WheeledCord/thinkpad-keyboard-usb/README.md

A PCB to allow a thinkpad laptop keyboard to be used as a USB keyboard.
