WheeledCord/thinkpad-keyboard-usb/kicad/T61.kicad_pcb

## KiCad design kicad/T61.kicad_pcb (2025-07-11)

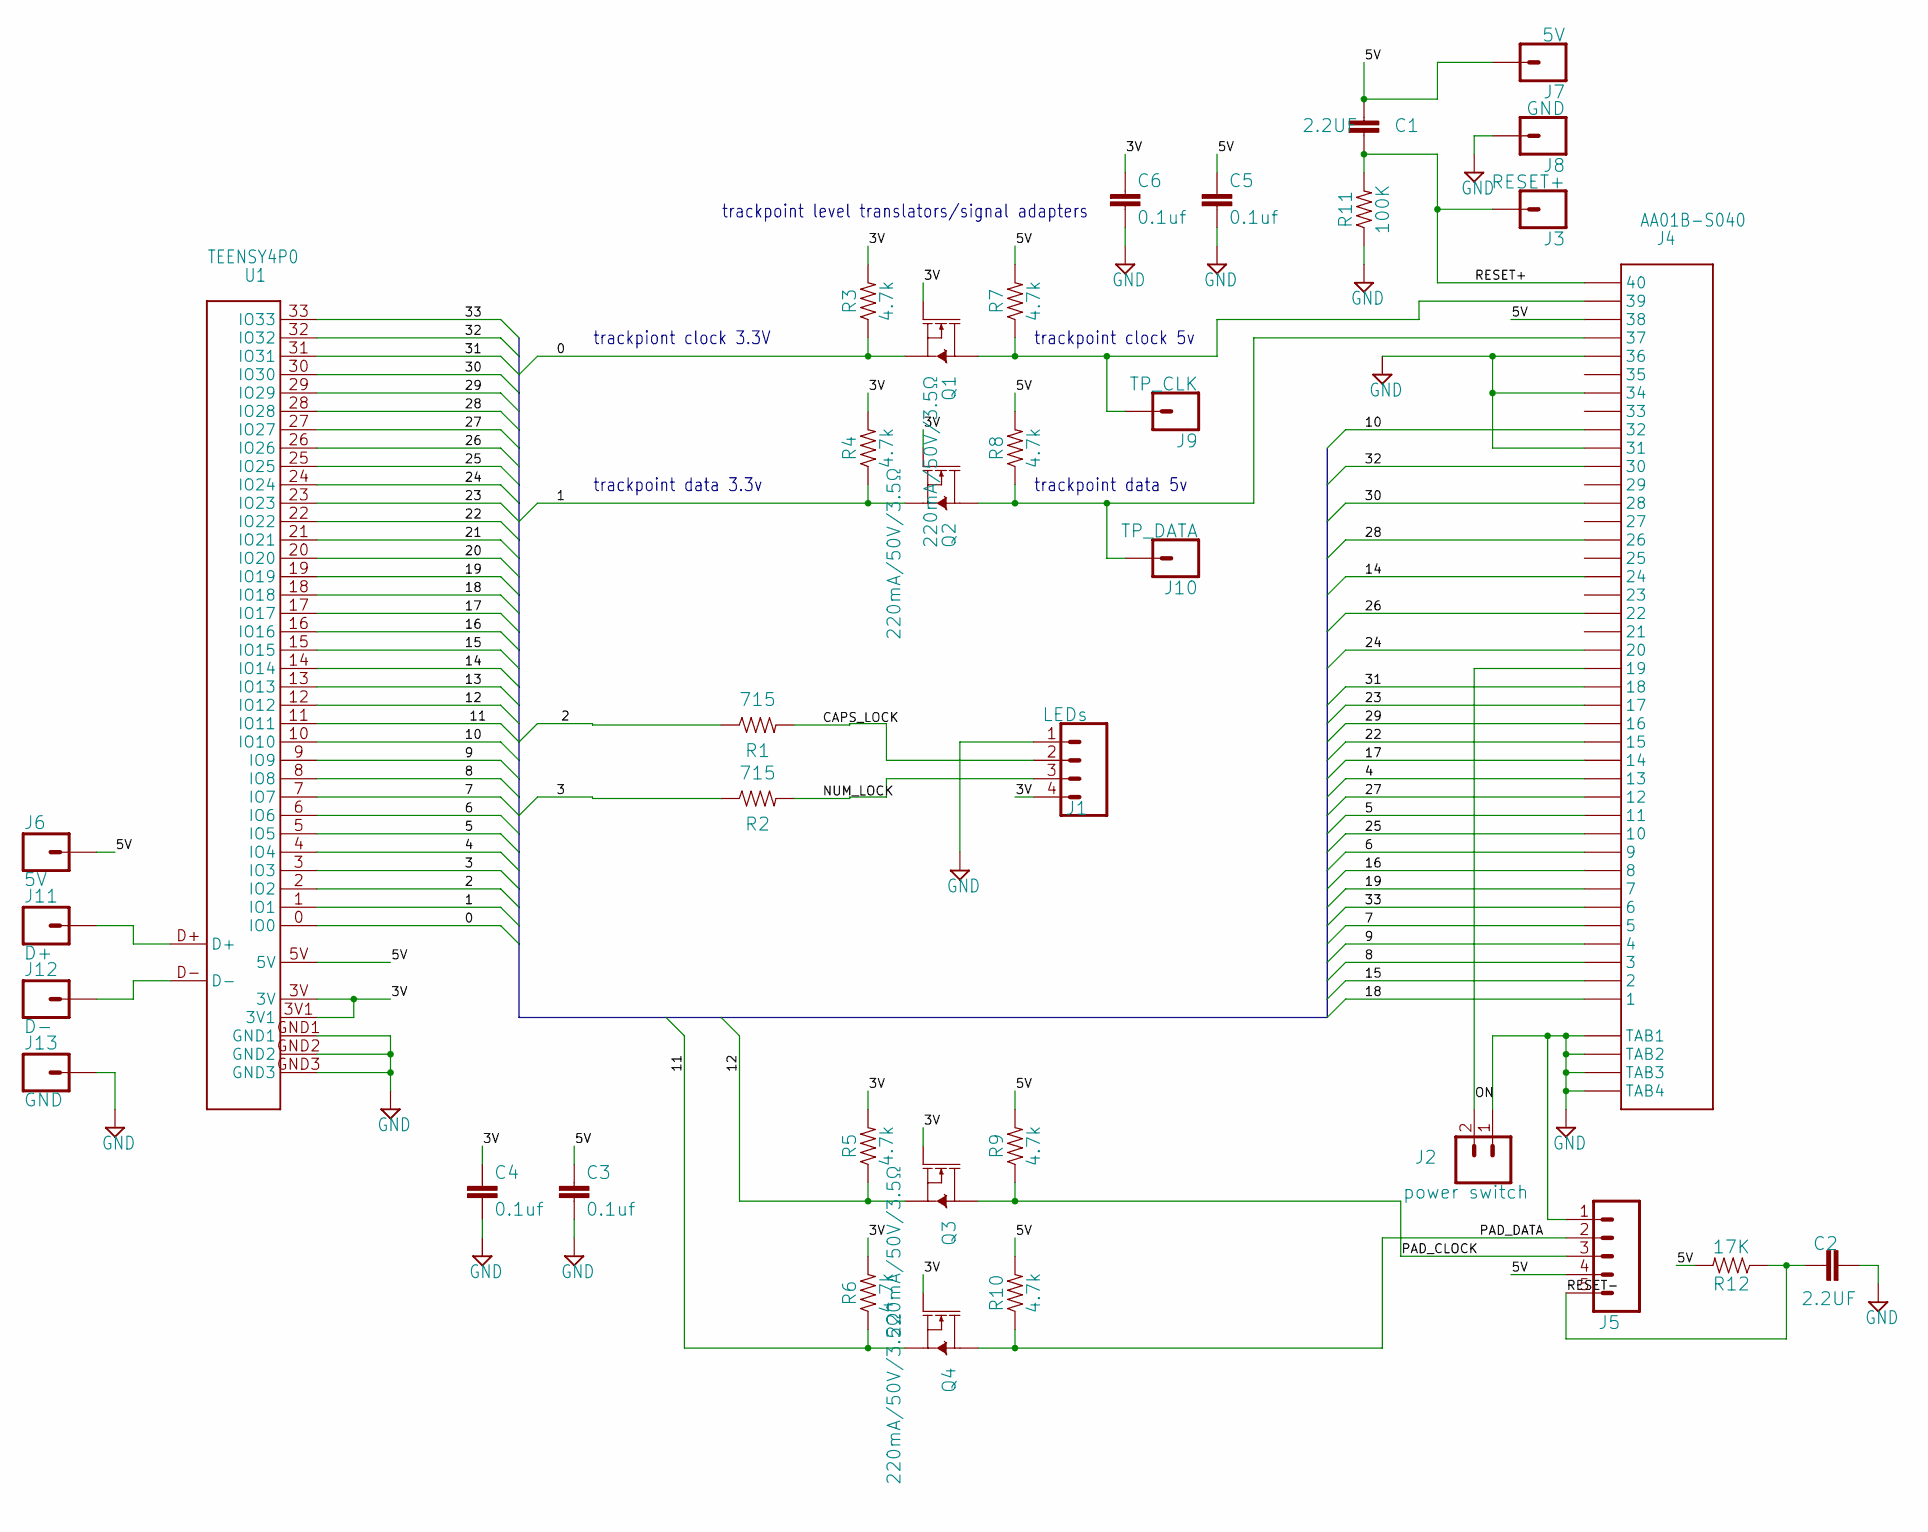
[picture p1: schematic T61.kicad_sch]

Parts:
C1, C2: 2.2UF; 0603_CAP
C3, C4, C5, C6: 0.1uf; 0603_CAP
J1: LEDs; 1X04
J2: power switch; 1X02
J3: RESET+; 1X01_NO_SILK
J4: AA01B-S040; WM6787_AA01B
J5: Touchpad_Signals; 1X05
J6, J7: 5V; 1X01_NO_SILK
J8, J13: GND; 1X01_NO_SILK
J9: TP_CLK; 1X01_NO_SILK
J10: TP_DATA; 1X01_NO_SILK
J11: D+; 1X01_NO_SILK
J12: D-; 1X01_NO_SILK
Q1, Q2, Q3, Q4: 220mA/50V/3.5Ω; SOT23-3
R1, R2: 715; 0603
R3, R4, R5, R6, R7, R8, R9, R10: 4.7k; 0603
R11: 100K; 0603_RESISTOR
R12: 17K; 0603_RESISTOR
U1: TEENSY4P0

Connections:
0: Q1.2 (S), R3.1, U1.0 (IO0)
1: Q2.2 (S), R4.1, U1.1 (IO1)
2: R1.1, U1.2 (IO2)
3: R2.1, U1.3 (IO3)
3V: C4.1, C6.1, J1.4, Q1.1 (G), Q2.1 (G), Q3.1 (G), Q4.1 (G), R3.2, R4.2, R5.2, R6.2, U1.3V, U1.3V1
4: J4.P$13 (13), U1.4 (IO4)
5: J4.P$11 (11), U1.5 (IO5)
5V: C1.1, C3.1, C5.1, J4.P$38 (38), J5.4, J6.1, J7.1, R7.2, R8.2, R9.2, R10.2, R12.2, U1.5V
6: J4.P$9 (9), U1.6 (IO6)
7: J4.P$5 (5), U1.7 (IO7)
8: J4.P$3 (3), U1.8 (IO8)
9: J4.P$4 (4), U1.9 (IO9)
10: J4.P$32 (32), U1.10 (IO10)
11: Q4.2 (S), R6.1, U1.11 (IO11)
12: Q3.2 (S), R5.1, U1.12 (IO12)
13: U1.13 (IO13)
14: J4.P$24 (24), U1.14 (IO14)
15: J4.P$2 (2), U1.15 (IO15)
16: J4.P$8 (8), U1.16 (IO16)
17: J4.P$14 (14), U1.17 (IO17)
18: J4.P$1 (1), U1.18 (IO18)
19: J4.P$7 (7), U1.19 (IO19)
20: U1.20 (IO20)
21: U1.21 (IO21)
22: J4.P$15 (15), U1.22 (IO22)
23: J4.P$17 (17), U1.23 (IO23)
24: J4.P$20 (20), U1.24 (IO24)
25: J4.P$10 (10), U1.25 (IO25)
26: J4.P$22 (22), U1.26 (IO26)
27: J4.P$12 (12), U1.27 (IO27)
28: J4.P$26 (26), U1.28 (IO28)
29: J4.P$16 (16), U1.29 (IO29)
30: J4.P$28 (28), U1.30 (IO30)
31: J4.P$18 (18), U1.31 (IO31)
32: J4.P$30 (30), U1.32 (IO32)
33: J4.P$6 (6), U1.33 (IO33)
CAPS_LOCK: J1.2, R1.2
D+: J11.1, U1.D+
D-: J12.1, U1.D-
GND: C2.2, C3.2, C4.2, C5.2, C6.2, J1.1, J2.1, J4.P$31 (31), J4.P$34 (34), J4.P$36 (36), J4.TAB1, J4.TAB2, J4.TAB3, J4.TAB4, J5.1, J8.1, J13.1, R11.1, U1.GND1, U1.GND2, U1.GND3
NUM_LOCK: J1.3, R2.2
ON: J2.2, J4.P$19 (19)
PAD_CLOCK: J5.3, Q3.3 (D), R9.1
PAD_DATA: J5.2, Q4.3 (D), R10.1
RESET+: C1.2, J3.1, J4.P$40 (40), R11.2
RESET-: C2.1, J5.5, R12.1
TP_CLK: J4.P$39 (39), J9.1, Q1.3 (D), R7.1
TP_DATA: J4.P$37 (37), J10.1, Q2.3 (D), R8.1

Notes on the sheet:
trackpoint data 5v
trackpiont clock 3.3V
trackpoint level translators/signal adapters
trackpoint clock 5v
trackpoint data 3.3v

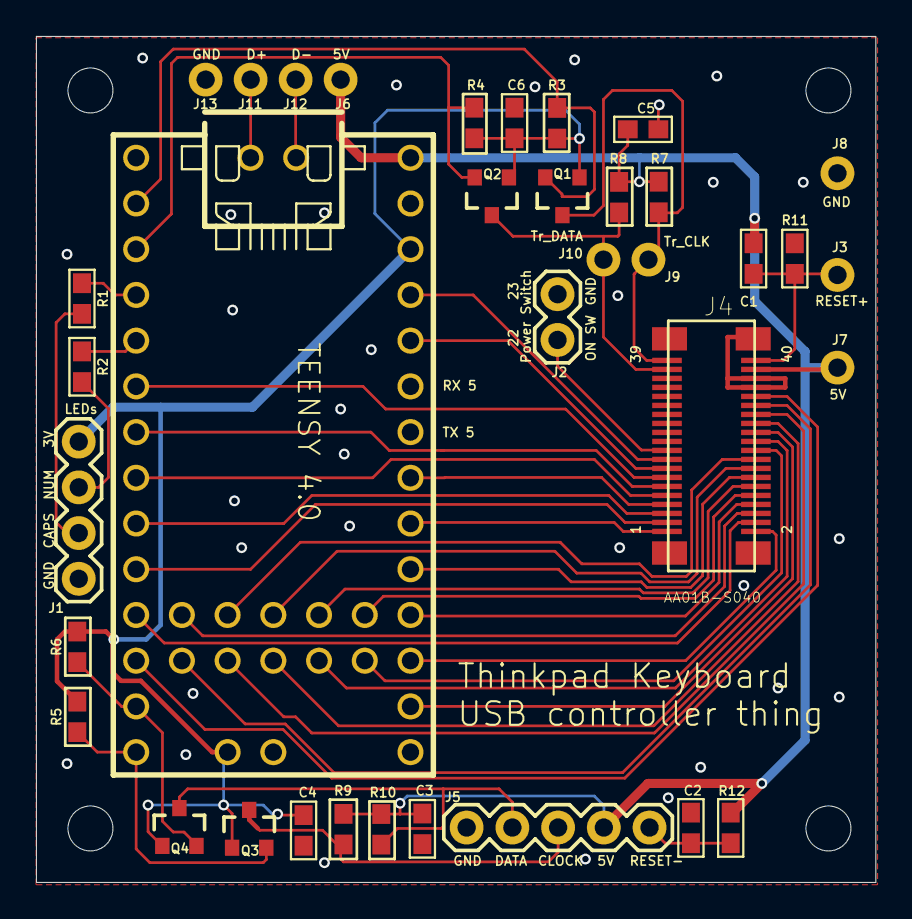
[picture p2: board T61.kicad_pcb from above]

Board: 2 copper layers, 46.6 x 47.0 mm, 40 parts (0 on the bottom side), 45 nets.

Other parts of the board:
UNK_HOLE_0: dummyfp0
UNK_HOLE_1: dummyfp1
UNK_HOLE_2: dummyfp2
UNK_HOLE_3: dummyfp3
